mamemomonga/MIDI2KORGSYNC/schematics/midi2korgsync.pdf

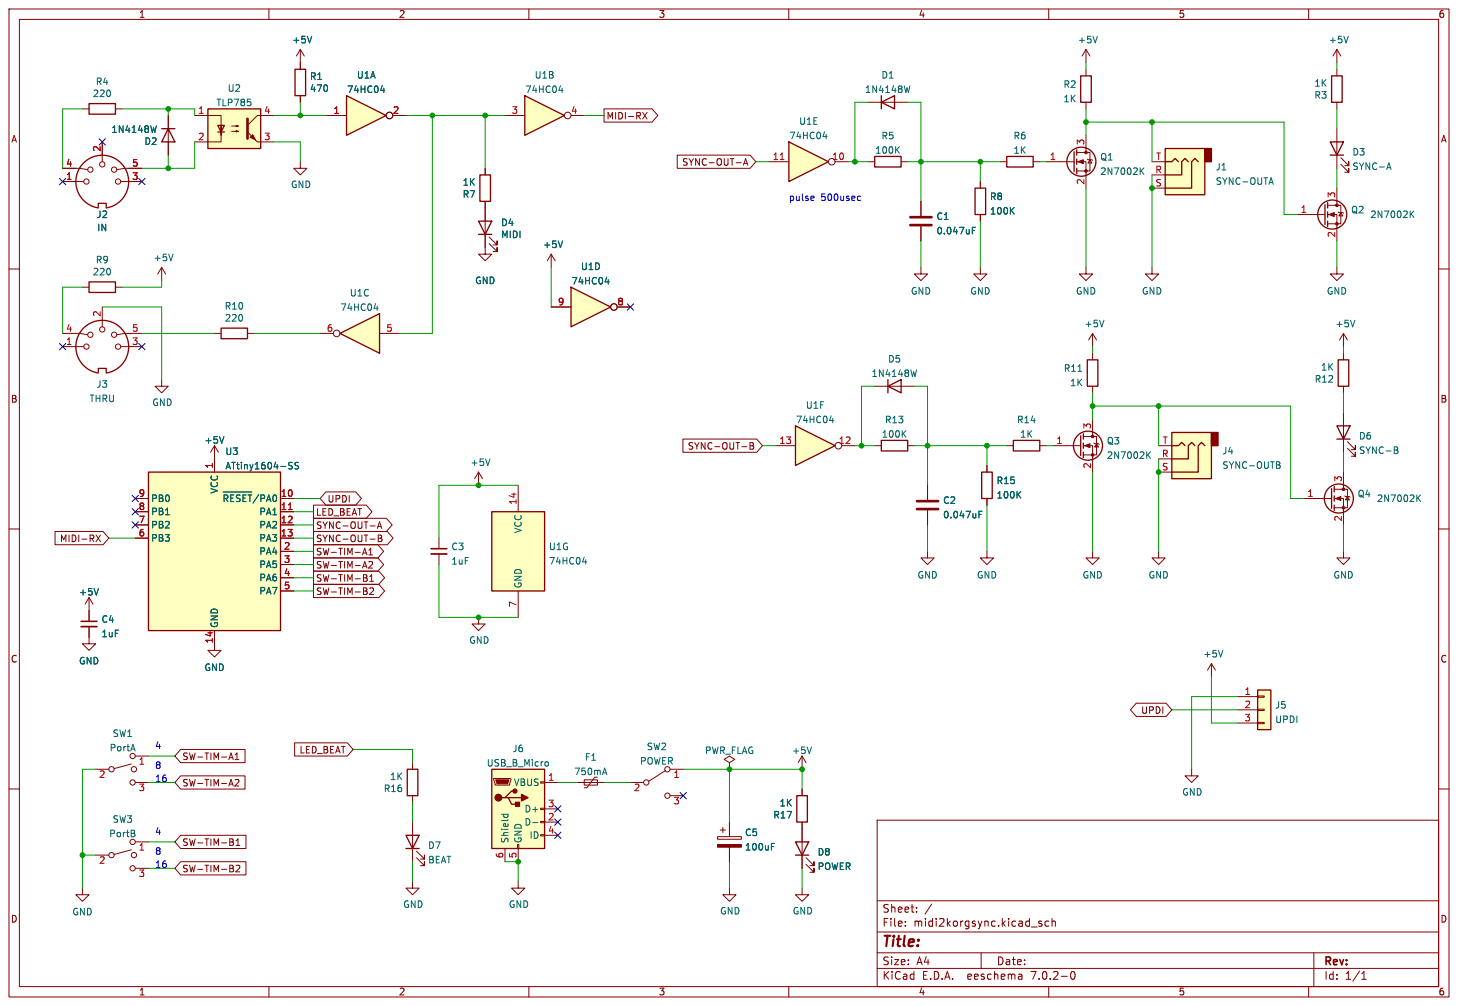
[picture p3: page 1]

Id: 1/1 Title: File: midi2korgsync.kicad_sch Sheet: /
