mamemomonga/MIDI2KORGSYNC/schematics/midi2korgsync.kicad_sch

## KiCad design schematics/midi2korgsync.kicad_sch (2023-09-30)

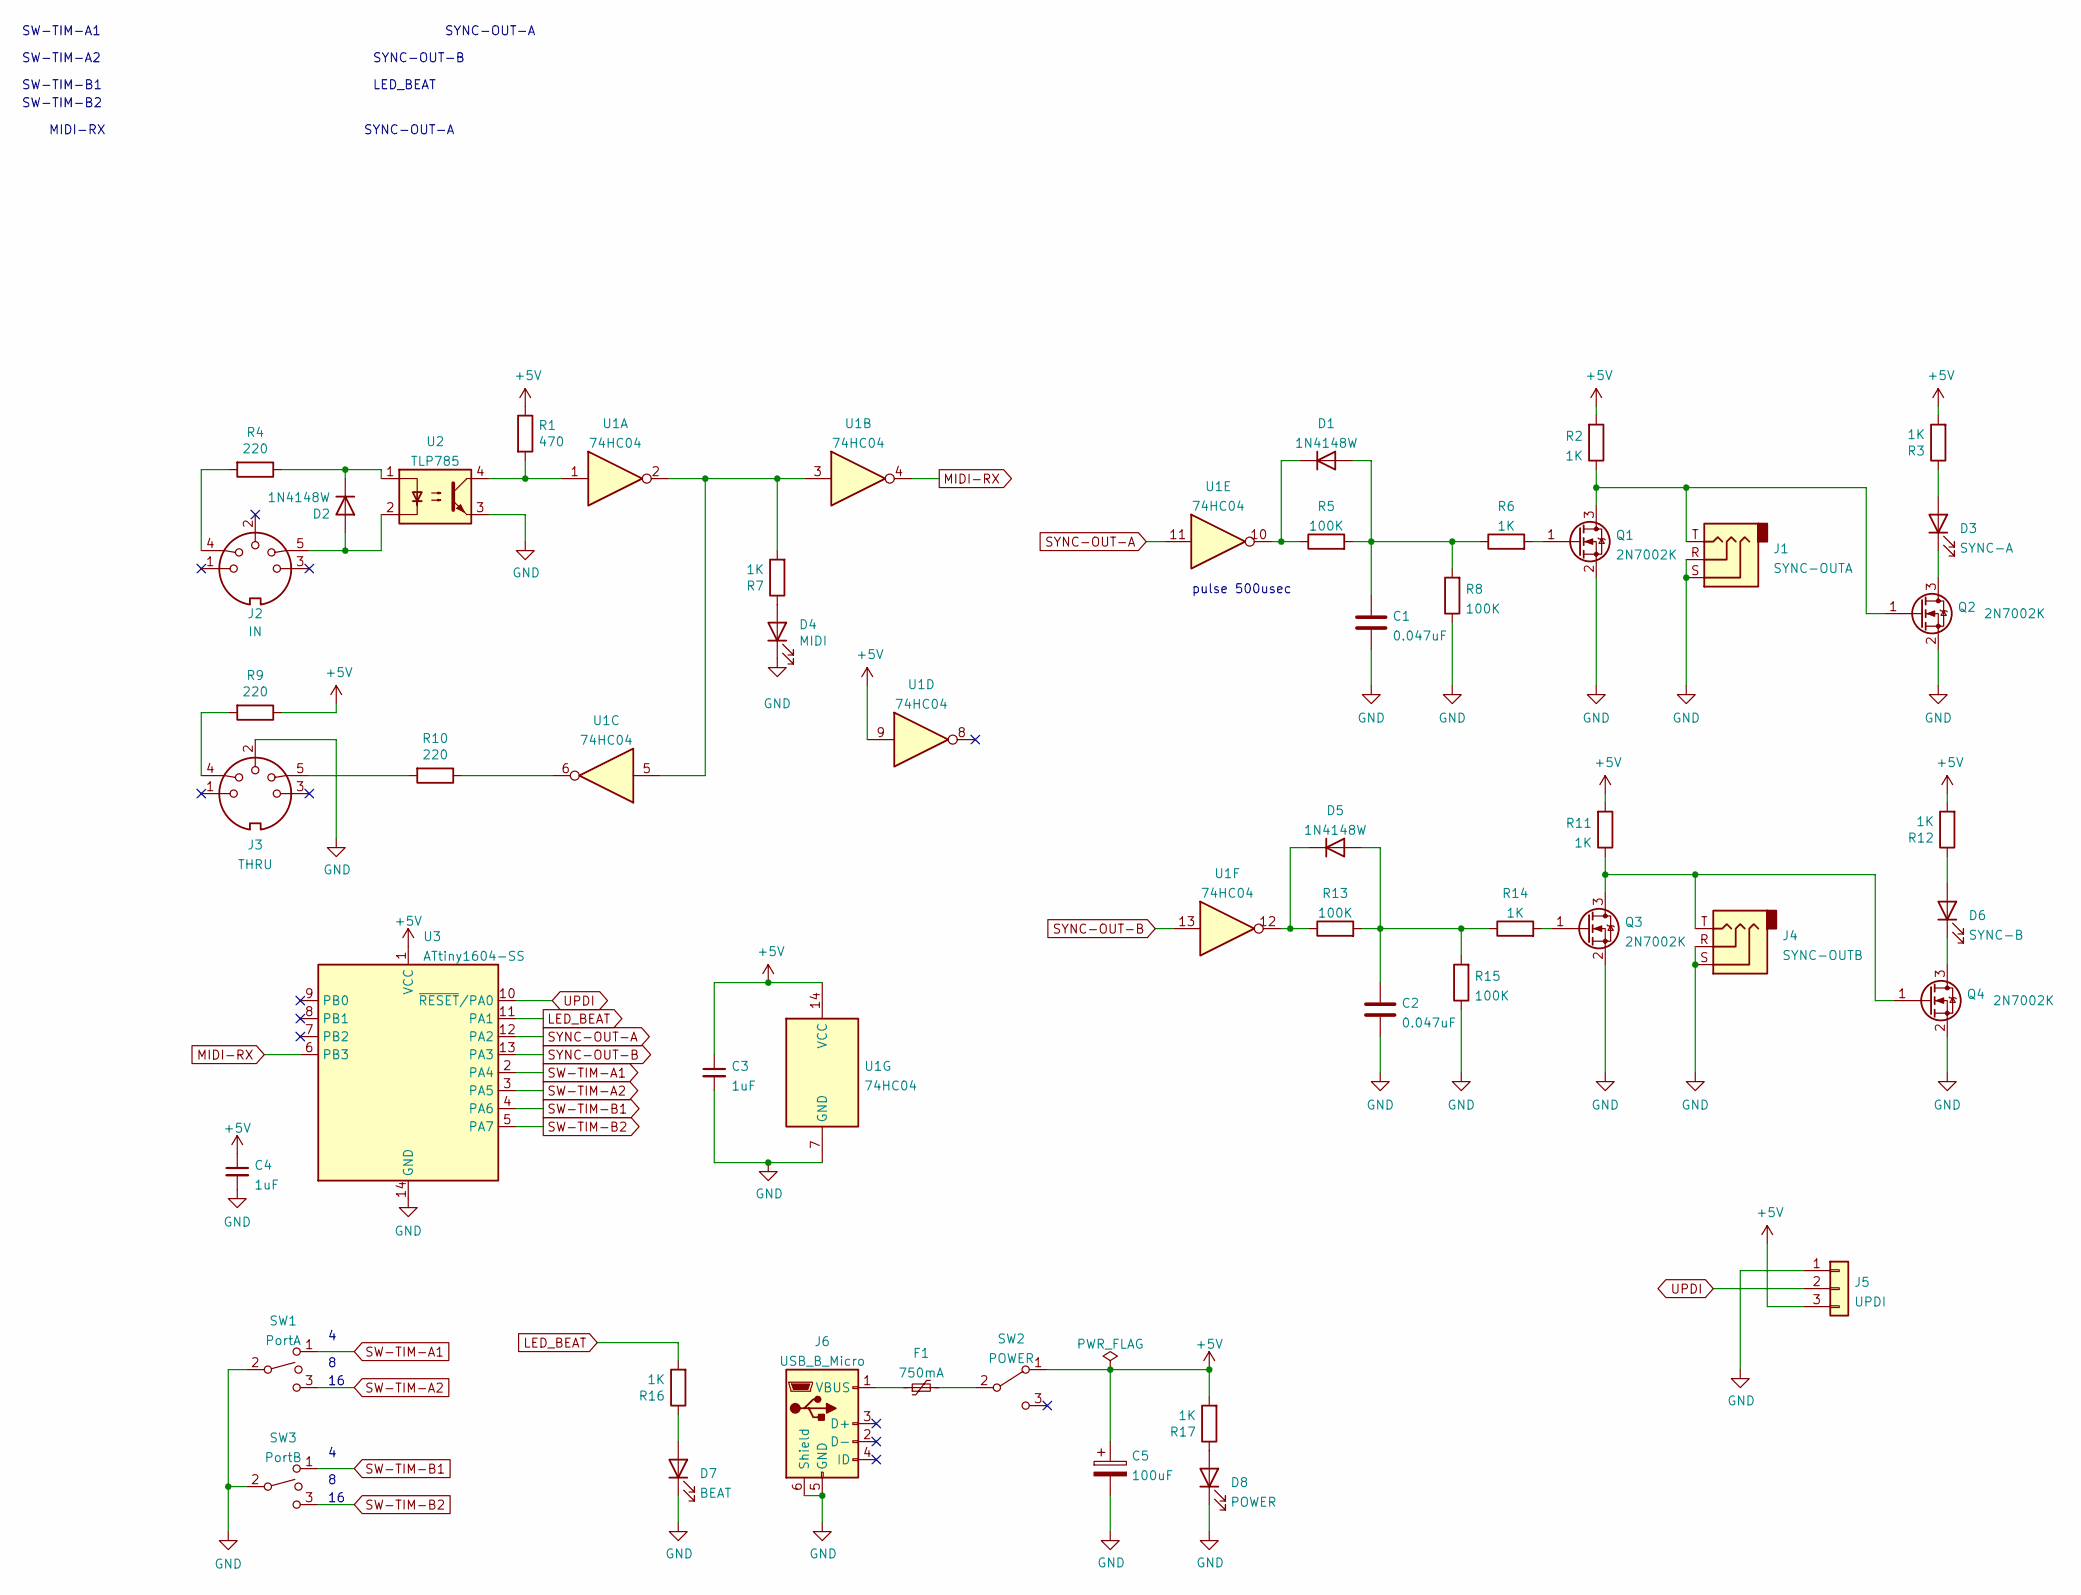
[picture p4: schematic midi2korgsync.kicad_sch]

Parts:
C1, C2: 0.047uF; C_Rect_L7.0mm_W3.5mm_P5.00mm
C3, C4: 1uF; C_0603_1608Metric_Pad1.08x0.95mm_HandSolder
C5: 100uF; CP_Radial_D5.0mm_P2.00mm
D1, D2, D5: 1N4148W; D_SOD-123
D3: SYNC-A; LED_0603_1608Metric_Pad1.05x0.95mm_HandSolder
D4: MIDI; LED_0603_1608Metric_Pad1.05x0.95mm_HandSolder
D6: SYNC-B; LED_0603_1608Metric_Pad1.05x0.95mm_HandSolder
D7: BEAT; LED_0603_1608Metric_Pad1.05x0.95mm_HandSolder
D8: POWER; LED_0603_1608Metric_Pad1.05x0.95mm_HandSolder
F1: 750mA; Fuse_0603_1608Metric_Pad1.05x0.95mm_HandSolder
J1: SYNC-OUTA; marushin MJ-8435
J2: IN; Useconn KDJ03-5
J3: THRU; Useconn KDJ03-5
J4: SYNC-OUTB; marushin MJ-8435
J5: UPDI; PinSocket_1x03_P2.54mm_Vertical
J6: USB_B_Micro; USB_Micro-B_Molex-105017-0001
Q1, Q2, Q3, Q4: 2N7002K; SOT-23
R1: 470; R_Axial_DIN0204_L3.6mm_D1.6mm_P2.54mm_Vertical
R2, R3, R6, R7, R11, R12, R14, R16, R17: 1K; R_0603_1608Metric_Pad0.98x0.95mm_HandSolder
R4, R9, R10: 220; R_Axial_DIN0204_L3.6mm_D1.6mm_P2.54mm_Vertical
R5, R8, R13, R15: 100K; R_0603_1608Metric_Pad0.98x0.95mm_HandSolder
SW1: PortA; Cosland 2MS3-T1-B4-M2-Q-E
SW2: POWER; Cosland 2MS3-T1-B4-M2-Q-E
SW3: PortB; Cosland 2MS3-T1-B4-M2-Q-E
U1: 74HC04; DIP-14_W7.62mm
U2: TLP785; DIP-4_W7.62mm
U3: ATtiny1604-SS; SOIC-14_3.9x8.7mm_P1.27mm

Connections:
+5V: C3.1, C4.1, C5.1, J5.3, R1.1, R2.2, R3.2, R9.1, R11.2, R12.2, R17.2, SW2.1 (A), U1.9, U1.14 (VCC), U3.1 (VCC)
GND: C1.2, C2.2, C3.2, C4.2, C5.2, D4.1 (K), D7.1 (K), D8.1 (K), J1.R, J1.S, J4.R, J4.S, J5.1, J6.5 (GND), J6.6 (Shield), Q1.2 (S), Q2.2 (S), Q3.2 (S), Q4.2 (S), R8.1, R15.1, SW1.2, SW3.2, U1.7 (GND), U2.3, U3.14 (GND)
LED_BEAT: R16.2, U3.11 (PA1)
MIDI-RX: U1.4, U3.6 (PB3)
unnamed: C1.1, D1.2 (A), R5.2, R6.1, R8.2
unnamed: C2.1, D5.2 (A), R13.2, R14.1, R15.2
unnamed: D1.1 (K), R5.1, U1.10
unnamed: D2.1 (K), R4.1, U2.1
unnamed: D2.2 (A), J2.5, U2.2
unnamed: D3.1 (K), Q2.3 (D)
unnamed: D3.2 (A), R3.1
unnamed: D4.2 (A), R7.1
unnamed: D5.1 (K), R13.1, U1.12
unnamed: D6.1 (K), Q4.3 (D)
unnamed: D6.2 (A), R12.1
unnamed: D7.2 (A), R16.1
unnamed: D8.2 (A), R17.1
unnamed: F1.1, J6.1 (VBUS)
unnamed: F1.2, SW2.2 (B)
unnamed: J1.T, Q1.3 (D), Q2.1 (G), R2.1
unnamed: J2.4, R4.2
unnamed: J3.4, R9.2
unnamed: J3.5, R10.2
unnamed: J4.T, Q3.3 (D), Q4.1 (G), R11.1
unnamed: Q1.1 (G), R6.2
unnamed: Q3.1 (G), R14.2
unnamed: R1.2, U1.1, U2.4
unnamed: R7.2, U1.2, U1.3, U1.5
unnamed: R10.1, U1.6
SW-TIM-A1: SW1.1, U3.2 (PA4)
SW-TIM-A2: SW1.3, U3.3 (PA5)
SW-TIM-B1: SW3.1, U3.4 (PA6)
SW-TIM-B2: SW3.3, U3.5 (PA7)
SYNC-OUT-A: U1.11, U3.12 (PA2)
SYNC-OUT-B: U1.13, U3.13 (PA3)
UPDI: J5.2, U3.10 (~RESET/PA0)

Notes on the sheet:
SW-TIM-A1
SYNC-OUT-A
MIDI-RX
SW-TIM-B2
SYNC-OUT-B
SW-TIM-B1
pulse 500usec
LED_BEAT
SW-TIM-A2
